afrakatirci/negatifiyonizer/gerceklemeresimleri/bd530a30-9193-4b18-a404-c11f3f073f79.jpg

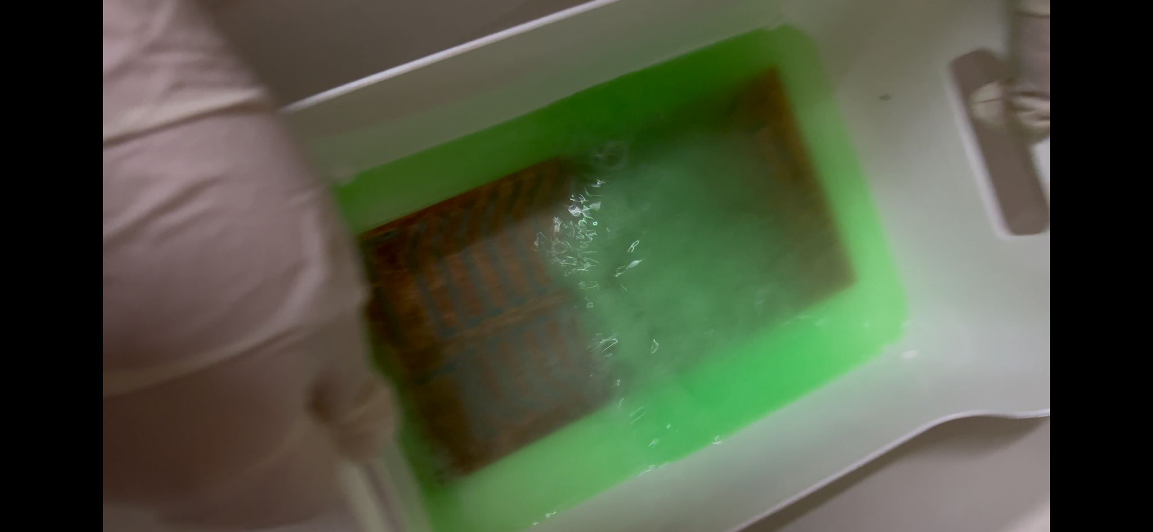
gerceklemeresimleri/bd530a30-9193-4b18-a404-c11f3f073f79.jpg
