afrakatirci/negatifiyonizer/gerceklemeresimleri/f606b000-ca39-45e2-9036-bc3188d56558.jpg

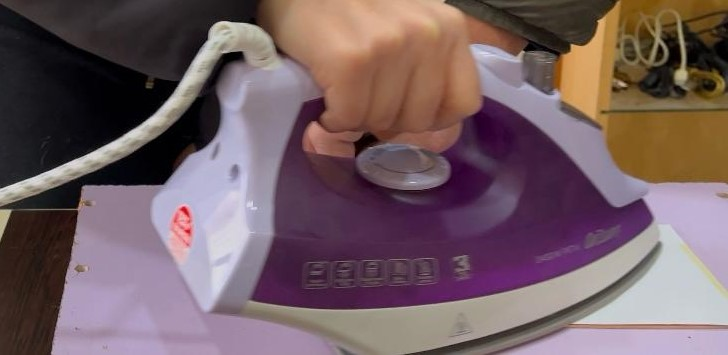
gerceklemeresimleri/f606b000-ca39-45e2-9036-bc3188d56558.jpg
