afrakatirci/negatifiyonizer/simulasyonresimleri/pcb.PNG

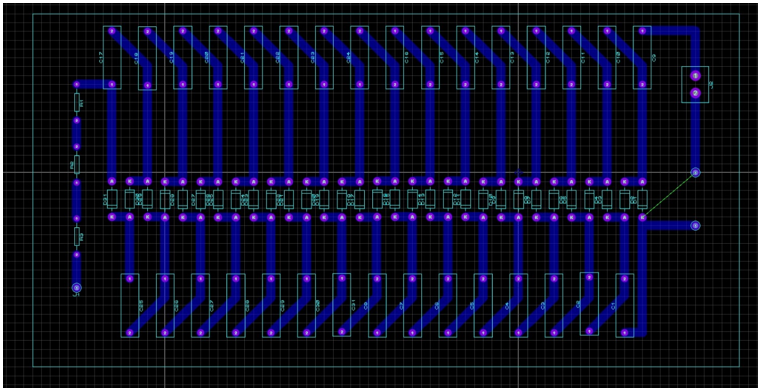
simulasyonresimleri/pcb.PNG
