afrakatirci/negatifiyonizer/(list of files, drawings)

Other design files:
simulasyon/İONİZER2 (1).pdsprj
